BhautikSarvaiya/Vehicle_Accident_Detection_and_Reporting_System/IMG-20260427-WA0011.jpg

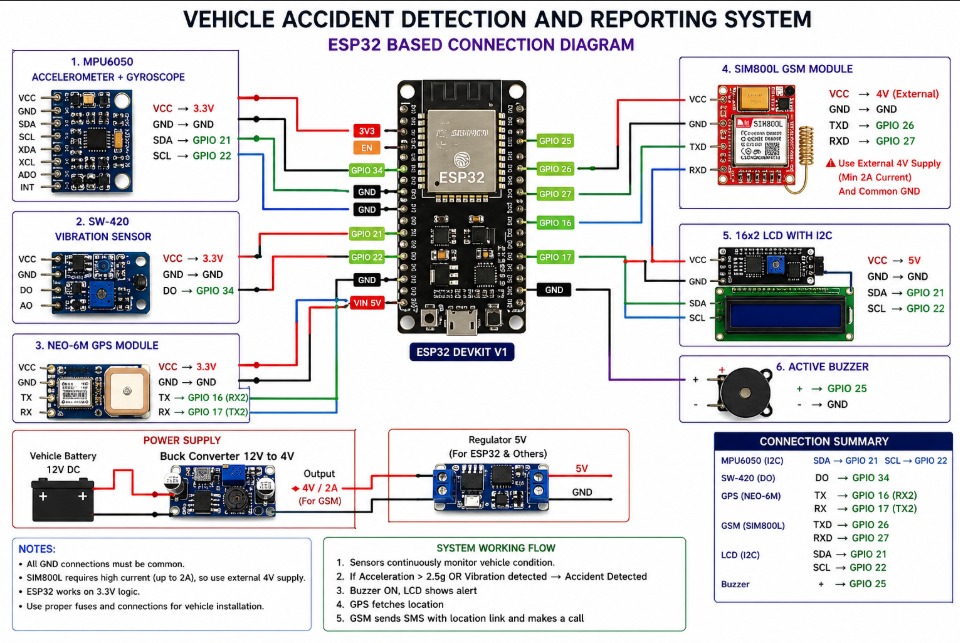
IMG-20260427-WA0011.jpg
